SunbirdAI/TalkToSema-Device-Documentation/images/deployed.png

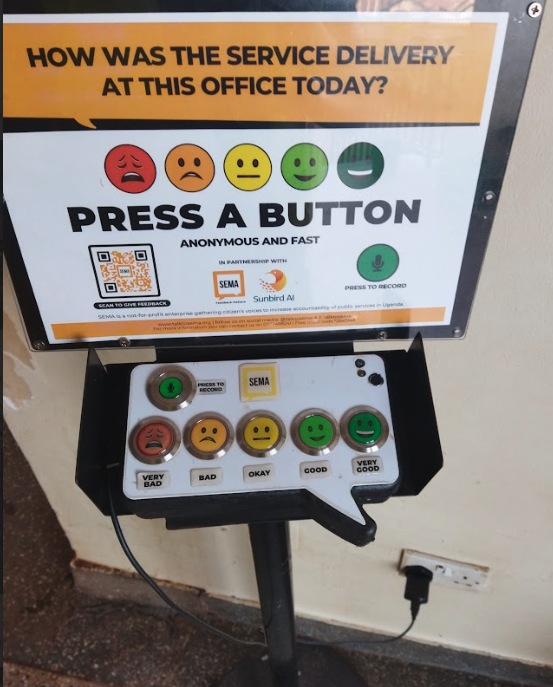
images/deployed.png
