SunbirdAI/TalkToSema-Device-Documentation/images/v1.2.png

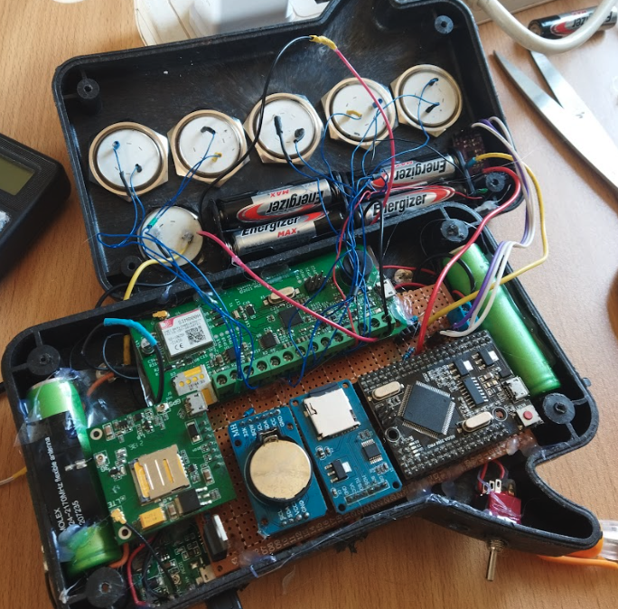
images/v1.2.png
