SunbirdAI/TalkToSema-Device-Documentation/schematics/sema-schematic-PCB-current-production-version.pdf

A | A

1

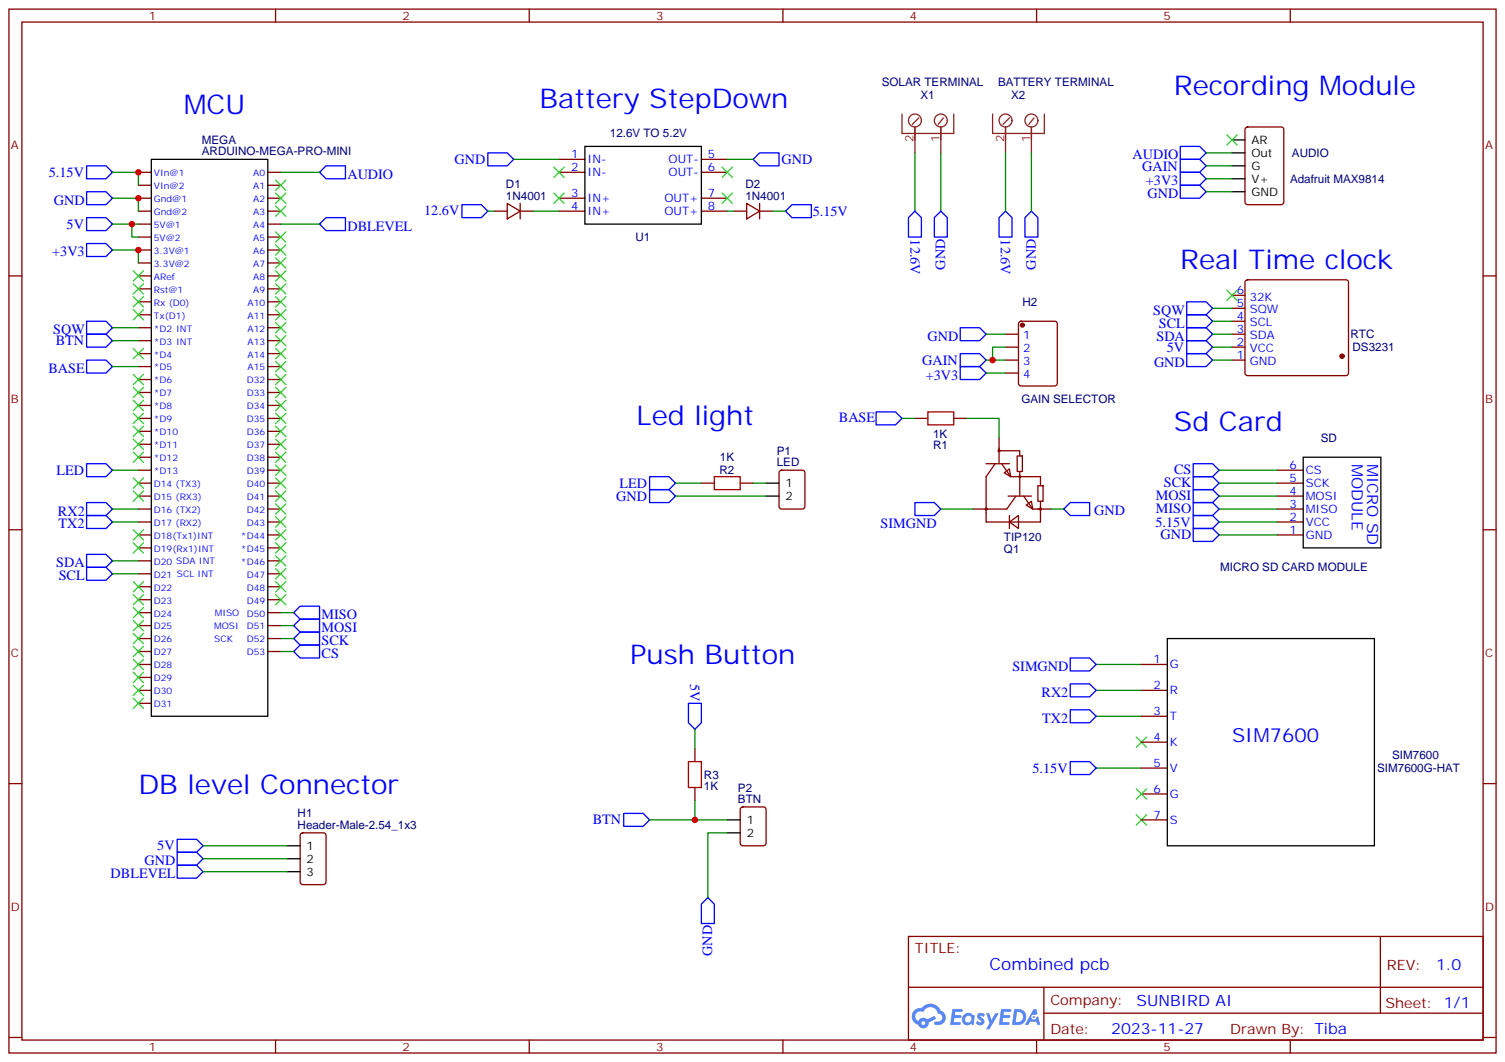
[picture p10: page 1]

MEGA
ARDUINO-MEGA-PRO-MINI

MICRO SD CARD MODULE
