SunbirdAI/TalkToSema-Device-Documentation/helperfunctions.ino

/*
 * Function to Enable 4G Communication 
*/
void enableCommunication(){
  
    if (digitalRead(gsmPin) == LOW) {
      digitalWrite(gsmPin, HIGH);
    }

    delay(6000); //give 6s to gsm to start fully
    
    SerialAT.begin(115200);

    #ifdef DEBUG
    SerialMon.println("Initializing modem");
    #endif
    
    // modem.init();
    SerialMon.println("Waiting for network...");
    if (!modem.waitForNetwork(600000L, true)) {
      delay(10000);
      return;
    }
    
    if (modem.isNetworkConnected()) {
      #ifdef DEBUG
      SerialMon.println("Network connected");
      #endif
    }
    else {
      SerialMon.println("Network Failed");
    }

    if (!modem.gprsConnect(apn)) {
      #ifdef DEBUG
      SerialMon.println("APN: fail");
      #endif
      delay(10000);
      return;
    }
    else {
      SerialMon.println("APN: internet");
    }

    // if (modem.isGprsConnected()) {
    //   #ifdef DEBUG
    //   SerialMon.println("GPRS connected");
    //   #endif
    // }
    // else {
    //   SerialMon.println("GPRS Failed");
    // }

    bool res = modem.isGprsConnected();
    if (res == true){
      SerialMon.println("GPRS CONNECTED");
    }else{
      SerialMon.println("GPRS failed");
    }
    
}

void disableCommunication(){
    if (digitalRead(gsmPin) == 1) {
      digitalWrite(gsmPin, 0);
      delay(200);
    }
    digitalWrite(gsmPin, 0);
    delay(200);
    
    #ifdef DEBUG
    SerialMon.println("Modem powered off");
    #endif  
}

/*
 * Function to Record Sound
 * Adjust delay value to +/- recording duration
*/
void startRec()
{
  digitalWrite(ledPin, HIGH);
  audio.startRecording(recName.c_str(), recFreq, recPin );
  #ifdef DEBUG
  SerialMon.println("recording Started");
  #endif
  delay(15000);
  // delay(60000); // adjust time of record
  audio.stopRecording( recName.c_str()) ;
  #ifdef DEBUG
  SerialMon.println("recording Stopped");
  #endif
  digitalWrite(ledPin, LOW);
  button_presses++;
  EEPROM.update(0, button_presses);
  recName = String(button_presses)+".wav";
  #ifdef DEBUG
  SerialMon.println("next File: "+recName);
  #endif
  
}

//log support file for recording
void logSupportfiles(){
  dataStringtime = "";
  rtcstamp = now.timestamp(DateTime::TIMESTAMP_FULL);
  dataStringtime = dataStringtime + rtcstamp;
  String savingName  = String(button_presses)+".txt";

  #ifdef DEBUG
  SerialMon.print("Support file: "); SerialMon.println(savingName);
  #endif

  if (SD.exists(savingName)) {
    #ifdef DEBUG
    SerialMon.println("File already exisits!");
    #endif
    SD.remove(savingName);
    #ifdef DEBUG
    SerialMon.println("Deleted: "+savingName);
    #endif
  }else{
    #ifdef DEBUG
    SerialMon.println("Creating Support File");
    #endif
  }

  File dataFiley = SD.open(savingName, FILE_WRITE);
  if (dataFiley) {
    dataFiley.println(dataStringtime);
    dataFiley.close();

    #ifdef DEBUG
    SerialMon.println("data saved successfully");
    #endif
  }
  else {
    #ifdef DEBUG
    SerialMon.println("error opening" + savingName);
    #endif
  }
}

/*
 * Function to Restart Unit to recover if Frozen 
*/
void restartDevice()
{
  #ifdef DEBUG
  SerialMon.println("Restarting Device --- Timer Elapsed");
  #endif
  resetFunc();
}

void SdCardSequence(){
  bool opencard = SD.begin(SD_ChipSelectPin);
  delay(5000);

  if(opencard == true){
    #ifdef DEBUG
    SerialMon.println("SD card Success");
    #endif
  }
  else{
    #ifdef DEBUG
    SerialMon.println("SD card Failed");
    #endif    
  }
}

void ledOnSequence(){
  digitalWrite(ledPin, HIGH);
  delay(200);
  digitalWrite(ledPin, LOW);
  delay(200);
  digitalWrite(ledPin, HIGH);
  delay(200);
  digitalWrite(ledPin, LOW);
  delay(200);
  digitalWrite(ledPin, HIGH);
}

void ledOffSequence(){
  digitalWrite(ledPin, HIGH);
  delay(200);
  digitalWrite(ledPin, LOW);
  delay(200);
  digitalWrite(ledPin, HIGH);
  delay(200);
  digitalWrite(ledPin, LOW);
  delay(200); 
}

// Function to read the voltage
float readVoltage() {
    int adc_value = analogRead(ANALOG_IN_PIN); // Read ADC
    float adc_voltage = (adc_value * ref_voltage) / 1024.0; // Convert to voltage
    float in_voltage = adc_voltage * (R1 + R2) / R2; // Calculate actual voltage
    return in_voltage;
}
