SunbirdAI/TalkToSema-Device-Documentation/(commit log)

2022-10-16 Update to Logic
    EEPROM keeps track of files
    Arduino-Timer library for restarting device every hour.
2023-02-10 Current Firmware Version with EEPROM fixed
    This firmware was updated on 19th Dec 2022
2023-03-09 Sleep Enabler
    RTC interrupt, button interrupt to trigger wakeup
2026-01-27 Update README.md
    added device versioning details to readme
2026-01-27 Update README.md
    schematics referenced
2026-01-28 Update README.md
    updates to battery configs
2026-01-28 Firmware update for IoT version
    Latest firmware update for SEMA devices.
